Ddoiron-cidco/Poseidon-PCB/PSU/PCB-Rev.1/bot.jpg

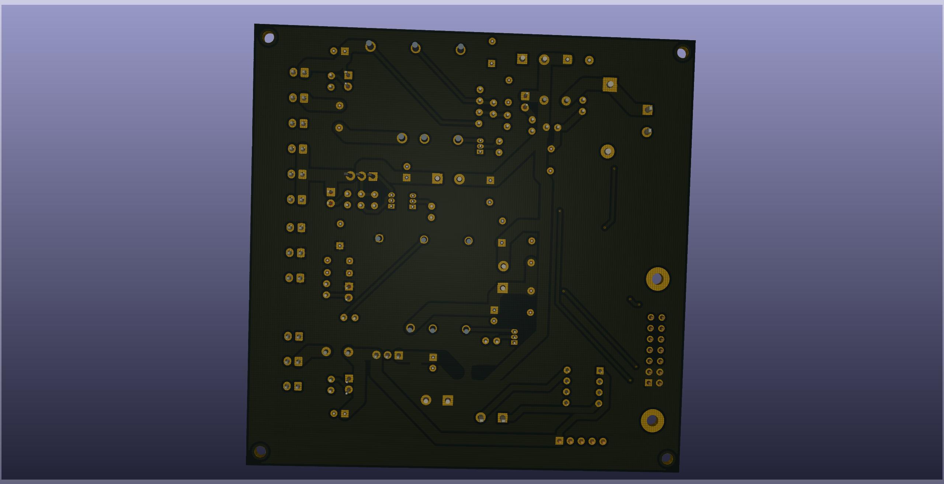
PSU/PCB-Rev.1/bot.jpg
