Ddoiron-cidco/Poseidon-PCB/PSU/PCB-Rev.1/pcb.jpg

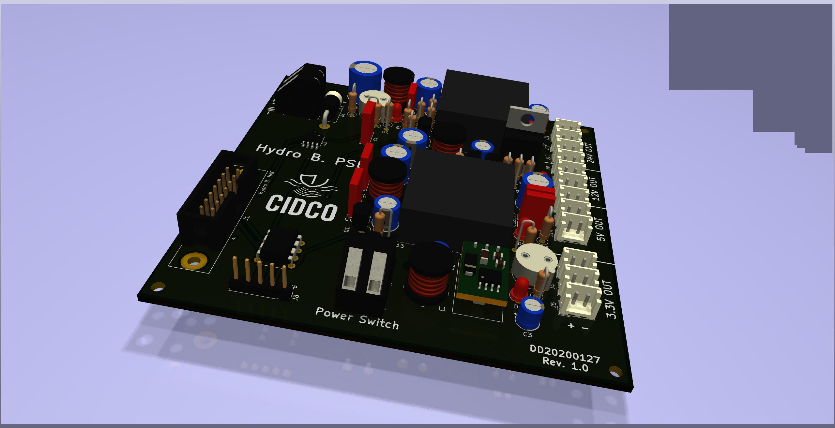
PSU/PCB-Rev.1/pcb.jpg
