Ddoiron-cidco/Poseidon-PCB/README.md

# Poseidon-PCB
PCBs for Poseidon Project

PCBs are design with Kicad 5.0
