Ddoiron-cidco/Poseidon-PCB/HAT/PCB Rev.1/pcb bot.jpg

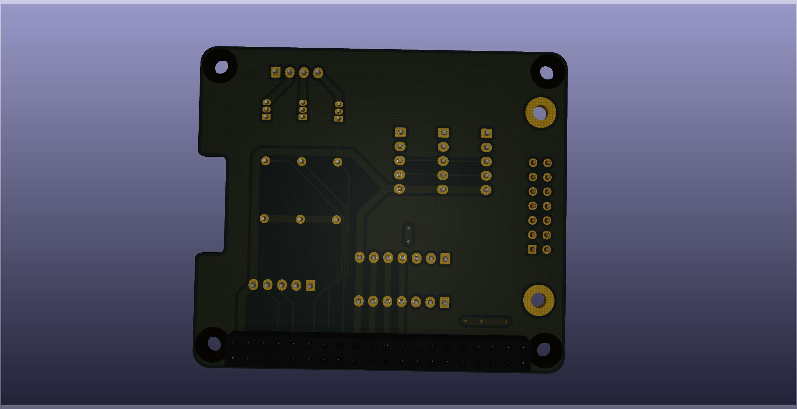
HAT/PCB Rev.1/pcb bot.jpg
