Ddoiron-cidco/Poseidon-PCB/HAT/PCB Rev.1/pcb top.jpg

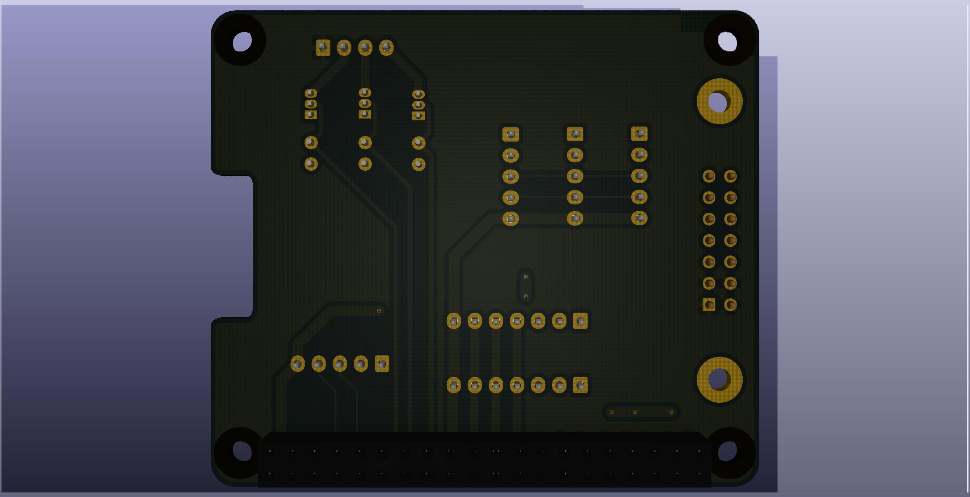
HAT/PCB Rev.1/pcb top.jpg
