Ddoiron-cidco/Poseidon-PCB/HAT/PCB Rev.1/pcb.jpg

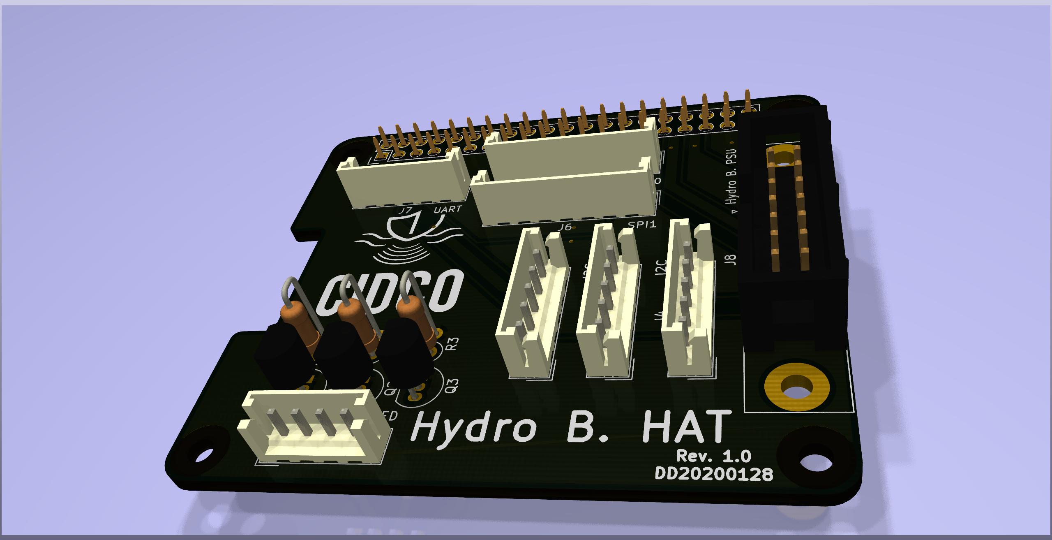
HAT/PCB Rev.1/pcb.jpg
