Ddoiron-cidco/Poseidon-PCB/PSU/PCB-Rev.1/top.jpg

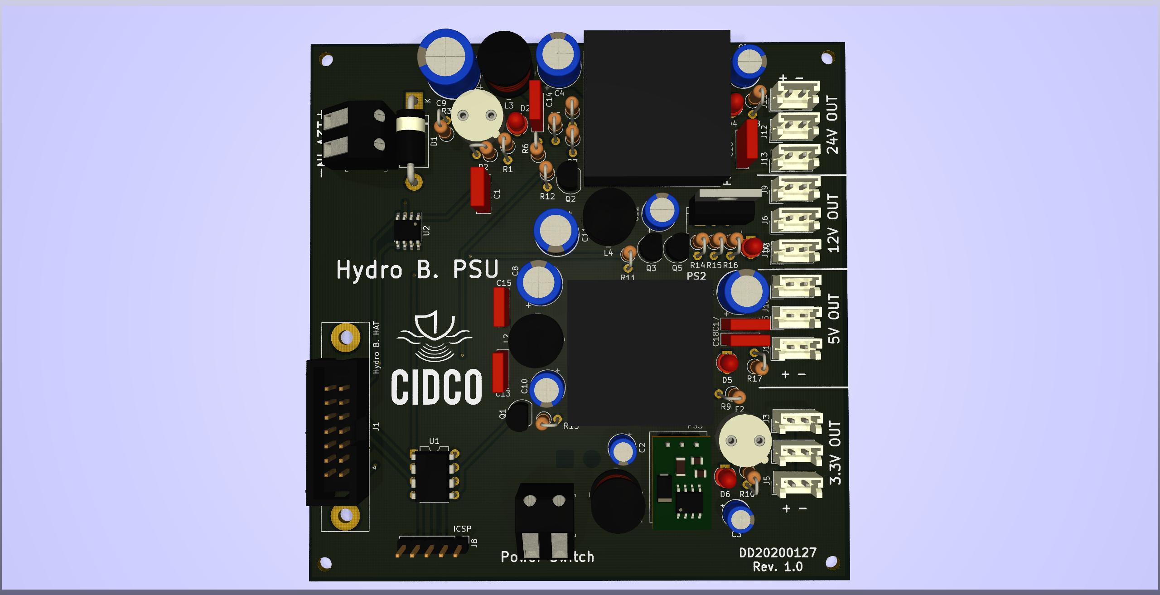
PSU/PCB-Rev.1/top.jpg
