Ddoiron-cidco/Poseidon-PCB/PSU/BOM PSU.ods

BOM
Hydro B. HAT
Location | Desc. | MFG PN | Digikey PN | Mouser PN | Newark PN | Arow PN
J1 | Wire-To-Board Connector, 2.54 mm, 14 Contacts, Header, FCI Quickie 71918 Series, Through Hole | 71918-214LF | 609-4495-ND | 649-71918-214LF | 62K7345 | 71918-214LF
J2,J7 | TERMINAL BLOCK, SCREW TYPE, 5.08 | TB007-508-02BE | 102-6203-ND | 490-TB007-508-02BE | *** | TB007-508-02BE
J3-J6,J9-J16 | CONN HEADER VERT 2POS 2.5MM | B2B-EH-A(LF)(SN) | 455-1611-ND | *** | 53X3090 | B2B-EH-A(LF)(SN)
J8 | NOT POPULATED
F1,F2 | FUSE HOLDER RADIAL 250V 6.3A PCB | 56000001009 | WK6235-ND | 576-56000001009 | 15P8392 | 56000001009
D1 | DIODE SCHOTTKY 40V 3A AXIAL | MBR340RLG | MBR340RLGOSCT-ND | 863-MBR340G | 38K4514 | MBR340RLG
D2-D6 | LED RED CLEAR T-1 T/H | WP710A10SECK/J3 | 754-1756-ND | 604-WP710A10SECKJ3 | *** | WP710A10SECK/J3
R1,R14,R15 | 10 kOhms ±1% 0.25W, 1/4W Through Hole Resistor Axial Metal Film | MFR-25FBF52-10K | 10.0KXBK-ND | 603-MFR-25FBF52-10K | *** | ***
R2 | 7.87 kOhms ±1% 0.25W, 1/4W Through Hole Resistor Axial Metal Film | MFR-25FBF52-7K87 | 7.87KXBK-ND | 603-MFR-25FBF52-7K87 | *** | ***
R3 | 1.27 kOhms ±1% 0.25W, 1/4W Through Hole Resistor Axial Metal Film | MFR-25FBF52-1K27 | 1.27KXBK-ND | 603-MFR-25FBF52-1K27 | *** | ***
R4
R5 | 20 kOhms ±1% 0.25W, 1/4W Through Hole Resistor Axial Metal Film | MFR-25FBF52-20K | 20.0KXBK-ND | 603-MFR-25FBF52-20K | *** | ***
R6 | 2.87 kOhms ±1% 0.25W, 1/4W Through Hole Resistor Axial Metal Film | MFR-25FBF52-2K87 | 2.87KXBK-ND | 603-MFR-25FBF52-2K87 | *** | ***
R7 | 24.9 kOhms ±1% 0.25W, 1/4W Through Hole Resistor Axial Metal Film | MFR-25FBF52-24K9 | 24.9KXBK-ND | 603-MFR-25FBF52-24K9 | *** | ***
R9
R10 | 220 Ohms ±5% 0.25W, 1/4W Through Hole Resistor Axial Carbon Film | CFR-25JB-52-220R | 220QBK-ND | 603-CFR-25JB-52-220R | *** | ***
R11-13 | 1 kOhms ±1% 0.25W, 1/4W Through Hole Resistor Axial Metal Film | MFR-25FBF52-1K | 1.00KXBK-ND | 603-MFR-25FBF52-1K | *** | ***
R16 | 2 kOhms ±1% 0.25W, 1/4W Through Hole Resistor Axial Metal Film | MFR-25FBF52-2K | 2.00KXBK-ND | 603-MFR-25FBF52-2K | *** | ***
R17 | 560 Ohms ±5% 0.25W, 1/4W Through Hole Resistor Axial Carbon Film | CFR-25JB-52-560R | 560QBK-ND | 603-CFR-25JB-52-560R | *** | ***
R18 | 3.9 kOhms ±5% 0.25W, 1/4W Through Hole Resistor Axial Carbon Film | CFR-25JB-52-3K9 | 3.9KQBK-ND | 603-CFR-25JB-52-3K9 | *** | ***
C1,C15,C18 | 0.1µF ±10% 50V Ceramic Capacitor X7R Radial | C322C104K5R5TA | 399-4329-ND | 80-C322C104K5R | 18K5744 | C322C104K5R5TA
C2,C3 | CAP ALUM 10UF 20% 35V RADIAL | ECA-1VM100I | P19549CT-ND | 667-ECA-1VM100I | *** | ECA-1VM100I
C4,C8,C11 | CAP ALUM 100UF 20% 50V RADIAL | ECA-1HHG101B | P19446CT-ND | 667-ECA-1HHG101B | *** | ***
C5,C10,C12 | CAP ALUM 47UF 20% 50V RADIAL | ECA-1HM470 | P5181-ND | 667-ECA-1HM470 | *** | ECA-1HM470
C7,C9 | CAP ALUM 330UF 20% 50V RADIAL | ECA-1HM331 | P5184-ND | 667-ECA-1HM331 | *** | ECA-1HM331
C13,C17 | CAP CER 10UF 50V X5R RADIAL | FG26X5R1H106KRT06 | 445-173434-1-ND | 810-FG26X5R1H106KRT6 | *** | FG26X5R1H106KRT06
C14 | CAP CER 4.7UF 50V X5R RADIAL | FG24X5R1H475KRT00 | 445-181258-ND | 810-FG24X5R1H475KRT0 | *** | FG24X5R1H475KRT00
C16 | CAP CER 1000PF 2KV Y5P RADIAL | S102K33Y5PP63K5R | 1252PH-ND | 594-S102K33Y5PP63K5R | S102K33Y5PP63K5R | S102K33Y5PP63K5R
L1,L2,L4 | FIXED IND 1UH 10A 13 MOHM TH | RL622-1R0K-RC | M9975-ND | 652-RL622-1R0K-RC | 86K3356 | RL622-1R0K-RC
L3 | FIXED IND 2.2UH 6.5A 21 MOHM TH | RL622-2R2K-RC | M9977-ND | 652-RL622-2R2K-RC | 86K3375 | RL622-2R2K-RC
Q1-Q3,Q5 | MOSFET Transistor, N Channel, 200 mA, 60 V, 1.2 ohm, 10 V, 2.1 V | 2N7000 | 2N7000FS-ND | 512-2N7000 | 98K6267 | 2N7000
Q4 | MOSFET P-CH 60V 27A TO-220 | FQP27P06 | FQP27P06-ND | 512-FQP27P06 | 58K1524 | FQP27P06
PS1 | DC-DC ISOLATED, 20 W, 9-36 VDC I | PDQE20-Q24-S24-D | 102-6270-ND | 490-PDQE20-Q24-S24-D | *** | ***
PS2 | DC DC CONVERTER 5V 30W | SKMW30F-05 | 1866-4667-ND |  | *** | SKMW30F-05
PS3 | DC DC CONVERTER 3.3V 5W | OKI-78SR-3.3/1.5-W36H-C | 811-3014-ND | 580-OKI78SR3.31.5WHC | 58T9850 | ***
U1 | IC MCU 8BIT 1.75KB FLASH 8DIP | PIC12F1501-I/P | PIC12F1501-I/P-ND | 579-PIC12F1501-I/P | 93T7733 | PIC12F1501-I/P
U2 | IC ADC 16BIT SIGMA-DELTA 8SOIC | MCP3426A0T-E/SN | MCP3426A0T-E/SNCT-ND | 579-MCP3426A0TE/SN | *** | ***
