Ddoiron-cidco/Poseidon-PCB/HAT/BOM HAT.ods

BOM
Hydro B. HAT
Location | Desc. | MFG PN | Digikey PN | Mouser PN | Newark PN | Arow PN
J1,J3,J4,J7 | Conn Shrouded Header (3 Sides) HDR 5 POS 2.5mm Solder ST Thru-Hole Box | B5B-EH-A(LF)(SN) | 455-1614-ND | *** | 90R8570 | B5B-EH-A(LF)(SN)
J2 | Headers & Wire Housings BOARDMT SKT HDR 40POS | 929852-01-20-RB | 3M156097-ND | 517-929852-01-20-RB | 62R6589 | 929852-01-20-RB
J5,J6 | Conn Shrouded Header (3 Sides) HDR 7 POS 2.5mm Solder ST Thru-Hole Box | B7B-EH-A(LF)(SN) | 455-1616-ND | *** | 90R8575 | B7B-EH-A(LF)(SN)
J8 | Wire-To-Board Connector, 2.54 mm, 14 Contacts, Header, FCI Quickie 71918 Series, Through Hole | 71918-214LF | 609-4495-ND | 649-71918-214LF | 62K7345 | 71918-214LF
J9 | Conn Shrouded Header (3 Sides) HDR 4 POS 2.5mm Solder ST Thru-Hole Box | B4B-EH-A(LF)(SN) | 455-1613-ND | *** | 90R8567 | B4B-EH-A(LF)(SN)
R1,R2,R3 | Through Hole Resistor, 1 kohm, MCF Series, 250 mW, ± 5%, Axial Leaded, 250 V | CFR-25JB-1K0 | 1.0KQBK-ND | 603-CFR-25JB-1K0 | 38K0327 | ***
Q1,Q2,Q3 | MOSFET Transistor, N Channel, 200 mA, 60 V, 1.2 ohm, 10 V, 2.1 V | 2N7000 | 2N7000FS-ND | 512-2N7000 | 98K6267 | 2N7000
