Ddoiron-cidco/Poseidon-PCB/HAT/PCB Rev.1/gerbers/fab.pdf

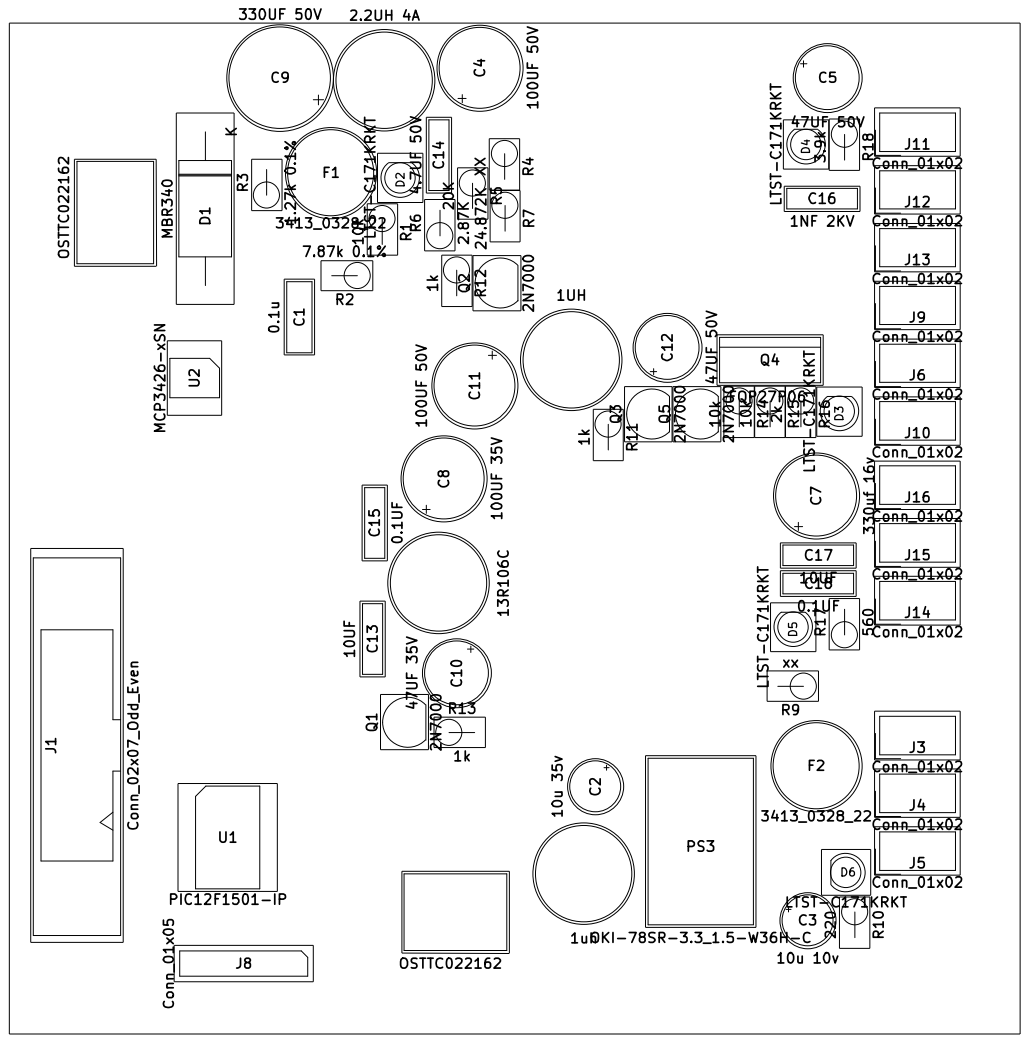
[picture p8: page 1]
