Ddoiron-cidco/Poseidon-PCB/PSU/PCB-Rev.1/psu-pcb.kicad_pcb

## KiCad design PSU/PCB-Rev.1/psu-pcb.kicad_pcb (2020-06-30)

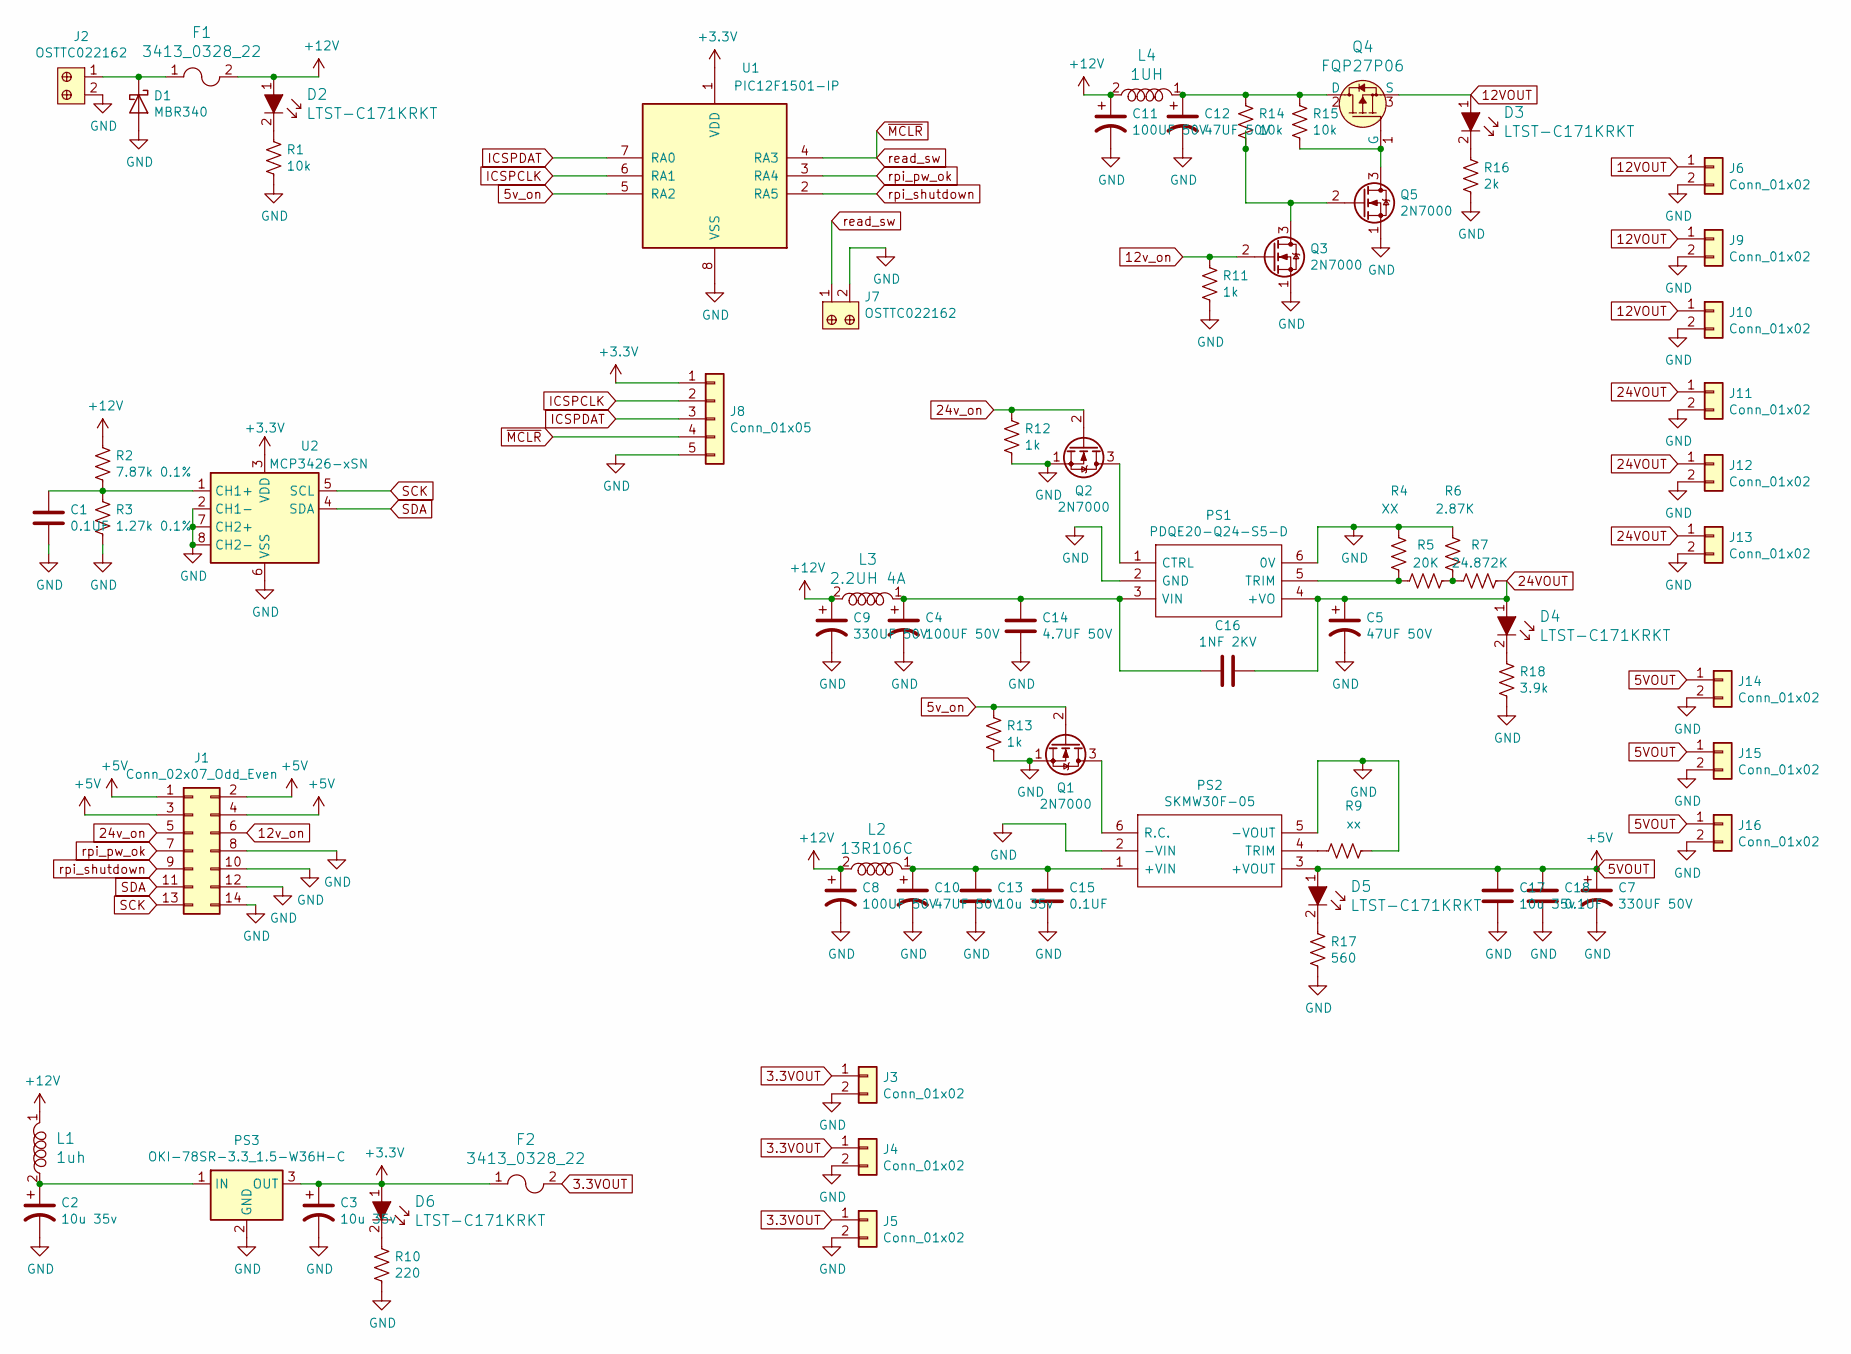
[picture p9: schematic psu-pcb.sch, Poseidon PSU]

Parts:
C1, C15, C18: 0.1UF; C_Rect_L7.0mm_W2.5mm_P5.00mm
C2, C3: 10u 35v; CP_Radial_D5.0mm_P2.50mm
C4, C8, C11: 100UF 50V; CP_Radial_D8.0mm_P5.00mm
C5, C10, C12: 47UF 50V; CP_Radial_D6.3mm_P2.50mm
C7, C9: 330UF 50V; CP_Radial_D10.0mm_P5.00mm
C13, C17: 10u 35v; C_Rect_L7.0mm_W2.0mm_P5.00mm
C14: 4.7UF 50V; C_Rect_L7.0mm_W2.0mm_P5.00mm
C16: 1NF 2KV; C_Rect_L7.0mm_W2.0mm_P5.00mm
D1: MBR340; D_DO-201AD_P15.24mm_Horizontal
D2, D3, D4, D5, D6: LTST-C171KRKT; LED_D3.0mm_Clear; MPN LTST-C171KRKT; Digi-Key_PN 160-1427-1-ND
F1, F2: 3413_0328_22; Fuse_Littelfuse_372_D8.50mm; MPN 3413.0328.22; Digi-Key_PN 486-1686-1-ND
J1: Conn_02x07_Odd_Even; IDC-Header_2x07_P2.54mm_Vertical_Lock
J2, J7: OSTTC022162; Term_Block_1x2_P5.08MM; MPN OSTTC022162; Digi-Key_PN ED2609-ND
J3, J4, J5, J6, J9, J10, J11, J12, J13, J14, J15, J16: Conn_01x02; JST_EH_B2B-EH-A_1x02_P2.50mm_Vertical
J8: Conn_01x05; PinHeader_1x05_P2.54mm_Vertical
L1: 1uh; Inductor_13R106C; MPN 13R106C; Digi-Key_PN 811-2058-ND
L2: 13R106C; Inductor_13R106C; MPN 13R106C; Digi-Key_PN 811-2058-ND
L3: 2.2UH 4A; Inductor_13R106C; MPN 13R106C; Digi-Key_PN 811-2058-ND
L4: 1UH; Inductor_13R106C; MPN 13R106C; Digi-Key_PN 811-2058-ND
PS1: PDQE20-Q24-S5-D; PDQE15Q24S5D; Manufacturer_Part_Number PDQE20-Q24-S5-D; Mouser Part Number 490-PDQE20-Q24-S5-D
PS2: SKMW30F-05; SKMW30G12; Manufacturer_Part_Number SKMW30G-12; Mouser Part Number 709-SKMW30G-12
PS3: OKI-78SR-3.3_1.5-W36H-C; Converter_DCDC_muRata_OKI-78SR_Horizontal
Q1, Q2, Q3, Q5: 2N7000; TO-92_Inline
Q4: FQP27P06; TO-220-3; MPN FQP27P06; Digi-Key_PN FQP27P06-ND
R1, R14, R15: 10k; R_Axial_DIN0207_L6.3mm_D2.5mm_P2.54mm_Vertical
R2: 7.87k 0.1%; R_Axial_DIN0207_L6.3mm_D2.5mm_P2.54mm_Vertical
R3: 1.27k 0.1%; R_Axial_DIN0207_L6.3mm_D2.5mm_P2.54mm_Vertical
R4: XX; R_Axial_DIN0207_L6.3mm_D2.5mm_P2.54mm_Vertical
R5: 20K; R_Axial_DIN0207_L6.3mm_D2.5mm_P2.54mm_Vertical
R6: 2.87K; R_Axial_DIN0207_L6.3mm_D2.5mm_P2.54mm_Vertical
R7: 24.872K; R_Axial_DIN0207_L6.3mm_D2.5mm_P2.54mm_Vertical
R9: xx; R_Axial_DIN0207_L6.3mm_D2.5mm_P2.54mm_Vertical
R10: 220; R_Axial_DIN0207_L6.3mm_D2.5mm_P2.54mm_Vertical
R11, R12, R13: 1k; R_Axial_DIN0207_L6.3mm_D2.5mm_P2.54mm_Vertical
R16: 2k; R_Axial_DIN0207_L6.3mm_D2.5mm_P2.54mm_Vertical
R17: 560; R_Axial_DIN0207_L6.3mm_D2.5mm_P2.54mm_Vertical
R18: 3.9k; R_Axial_DIN0207_L6.3mm_D2.5mm_P2.54mm_Vertical
U1: PIC12F1501-IP; DIP-8_W7.62mm
U2: MCP3426-xSN; SOIC-8-1EP_3.9x4.9mm_P1.27mm_EP2.29x3mm

Connections:
3.3VOUT: F2.2, J3.1, J4.1, J5.1
5VOUT: C7.1, C17.1, C18.1, D5.1, J1.1, J1.2, J1.3, J1.4, J14.1, J15.1, J16.1, PS2.3 (+VOUT)
5v_on: Q1.2 (G), R13.1, U1.5 (RA2)
12VOUT: D3.1, J6.1, J9.1, J10.1, Q4.3 (S)
12v_on: J1.6, Q3.2 (G), R11.1
24VOUT: C5.1, C16.2, D4.1, J11.1, J12.1, J13.1, PS1.4 (+VO), R7.2
24v_on: J1.5, Q2.2 (G), R12.1
+3V3: C3.1, D6.1, F2.1, J8.1, PS3.3 (OUT), U1.1 (VDD), U2.3 (VDD)
+12V: C8.1, C9.1, C11.1, D2.1, F1.2, L1.1, L2.2, L3.2, L4.2, R2.1
GND: C1.2, C2.2, C3.2, C4.2, C5.2, C7.2, C8.2, C9.2, C10.2, C11.2, C12.2, C13.2, C14.2, C15.2, C17.2, C18.2, D1.2 (A), J1.8, J1.10, J1.12, J1.14, J2.2, J3.2, J4.2, J5.2, J6.2, J7.2, J8.5, J9.2, J10.2, J11.2, J12.2, J13.2, J14.2, J15.2, J16.2, PS1.2 (GND), PS1.6 (0V), PS2.2 (-VIN), PS2.5 (-VOUT), PS3.2 (GND), Q1.1 (S), Q2.1 (S), Q3.1 (S), Q5.1 (S), R1.2, R3.2, R4.1, R6.1, R9.2, R10.2, R11.2, R12.2, R13.2, R16.2, R17.2, R18.2, U1.8 (VSS), U2.2 (CH1-), U2.6 (VSS), U2.7 (CH2+), U2.8 (CH2-)
ICSPCLK: J8.2, U1.6 (RA1)
ICSPDAT: J8.3, U1.7 (RA0)
unnamed: C2.1, L1.2, PS3.1 (IN)
unnamed: C10.1, C13.1, C15.1, L2.1, PS2.1 (+VIN)
unnamed: C12.1, L4.1, Q4.2 (D), R14.1, R15.1
unnamed: C4.1, C14.1, C16.1, L3.1, PS1.3 (VIN)
unnamed: D1.1 (K), F1.1, J2.1
unnamed: D2.2, R1.1
unnamed: D3.2, R16.1
unnamed: D4.2, R18.1
unnamed: D5.2, R17.1
unnamed: D6.2, R10.1
unnamed: PS1.1 (CTRL), Q2.3 (D)
unnamed: PS1.5 (TRIM), R4.2, R5.1
unnamed: PS2.4 (TRIM), R9.1
unnamed: PS2.6 (R.C.), Q1.3 (D)
unnamed: Q3.3 (D), Q5.2 (G), R14.2
unnamed: Q4.1 (G), Q5.3 (D), R15.2
unnamed: R5.2, R6.2, R7.1
SCK: J1.13, U2.5 (SCL)
SDA: J1.11, U2.4 (SDA)
read_sw: J7.1, J8.4, U1.4 (RA3)
rpi_pw_ok: J1.7, U1.3 (RA4)
rpi_shutdown: J1.9, U1.2 (RA5)

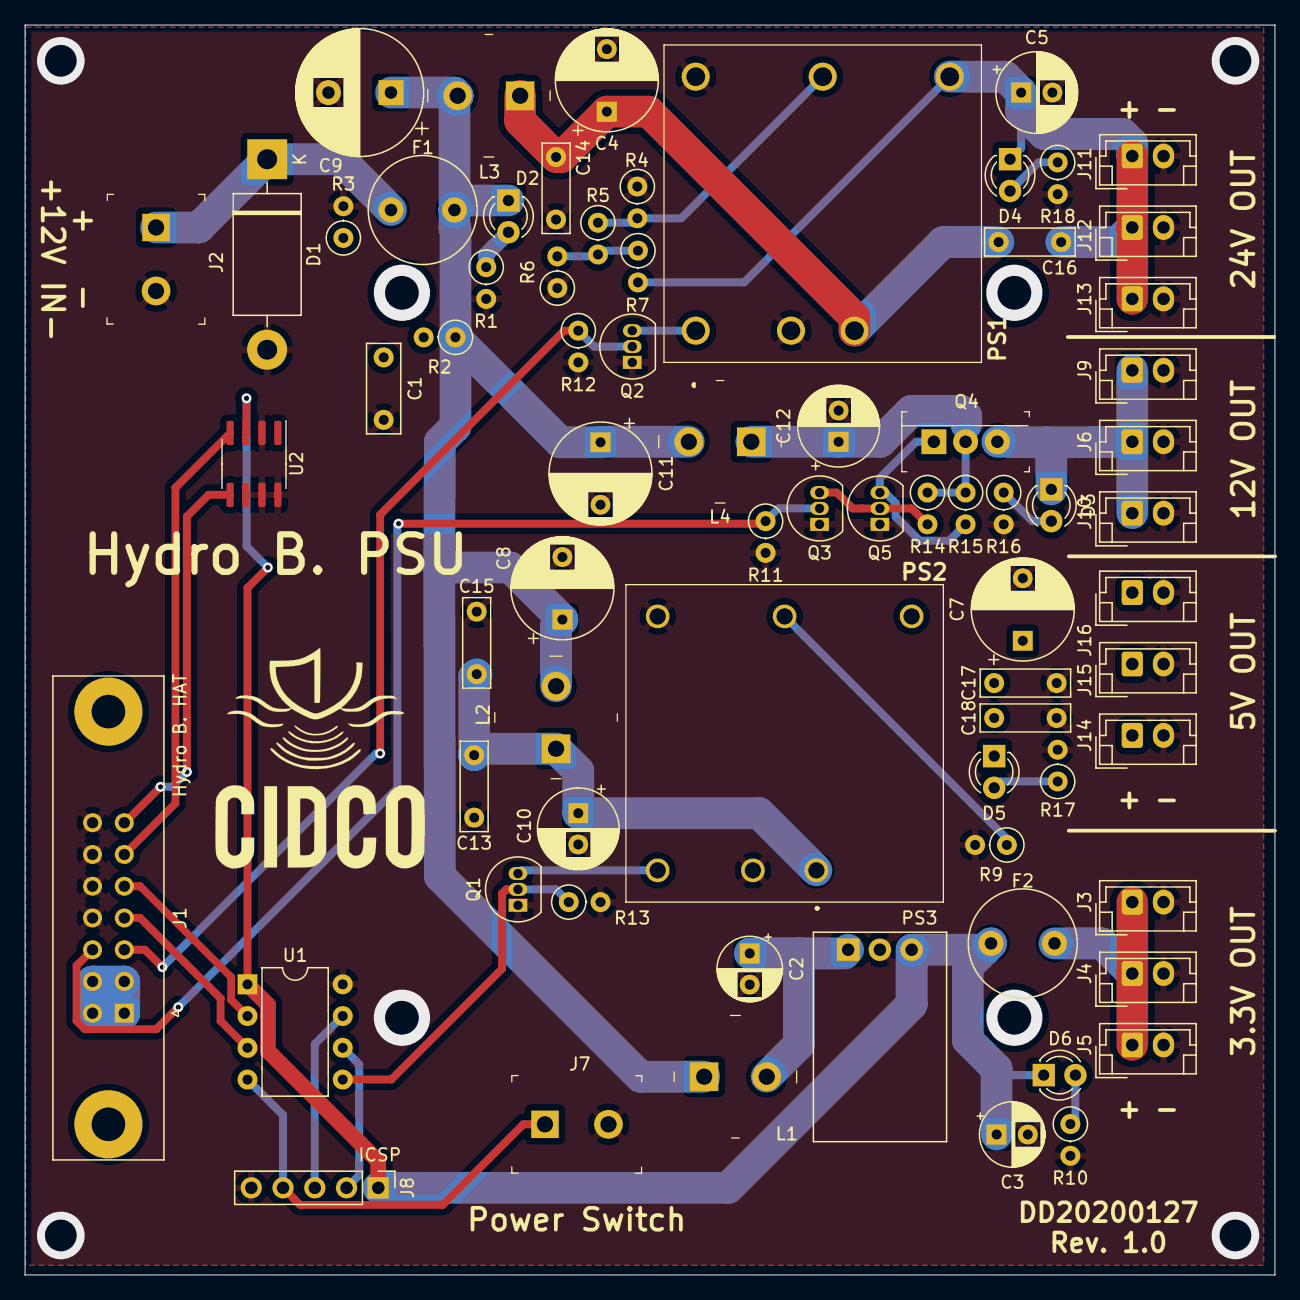
[picture p10: board psu-pcb.kicad_pcb from above]

Board: 2 copper layers, 100.0 x 100.0 mm, 72 parts (0 on the bottom side), 34 nets.
