Ddoiron-cidco/Poseidon-PCB/HAT/PCB Rev.1/RPi_Hat.kicad_pcb

## KiCad design HAT/PCB Rev.1/RPi_Hat.kicad_pcb (2020-01-30)

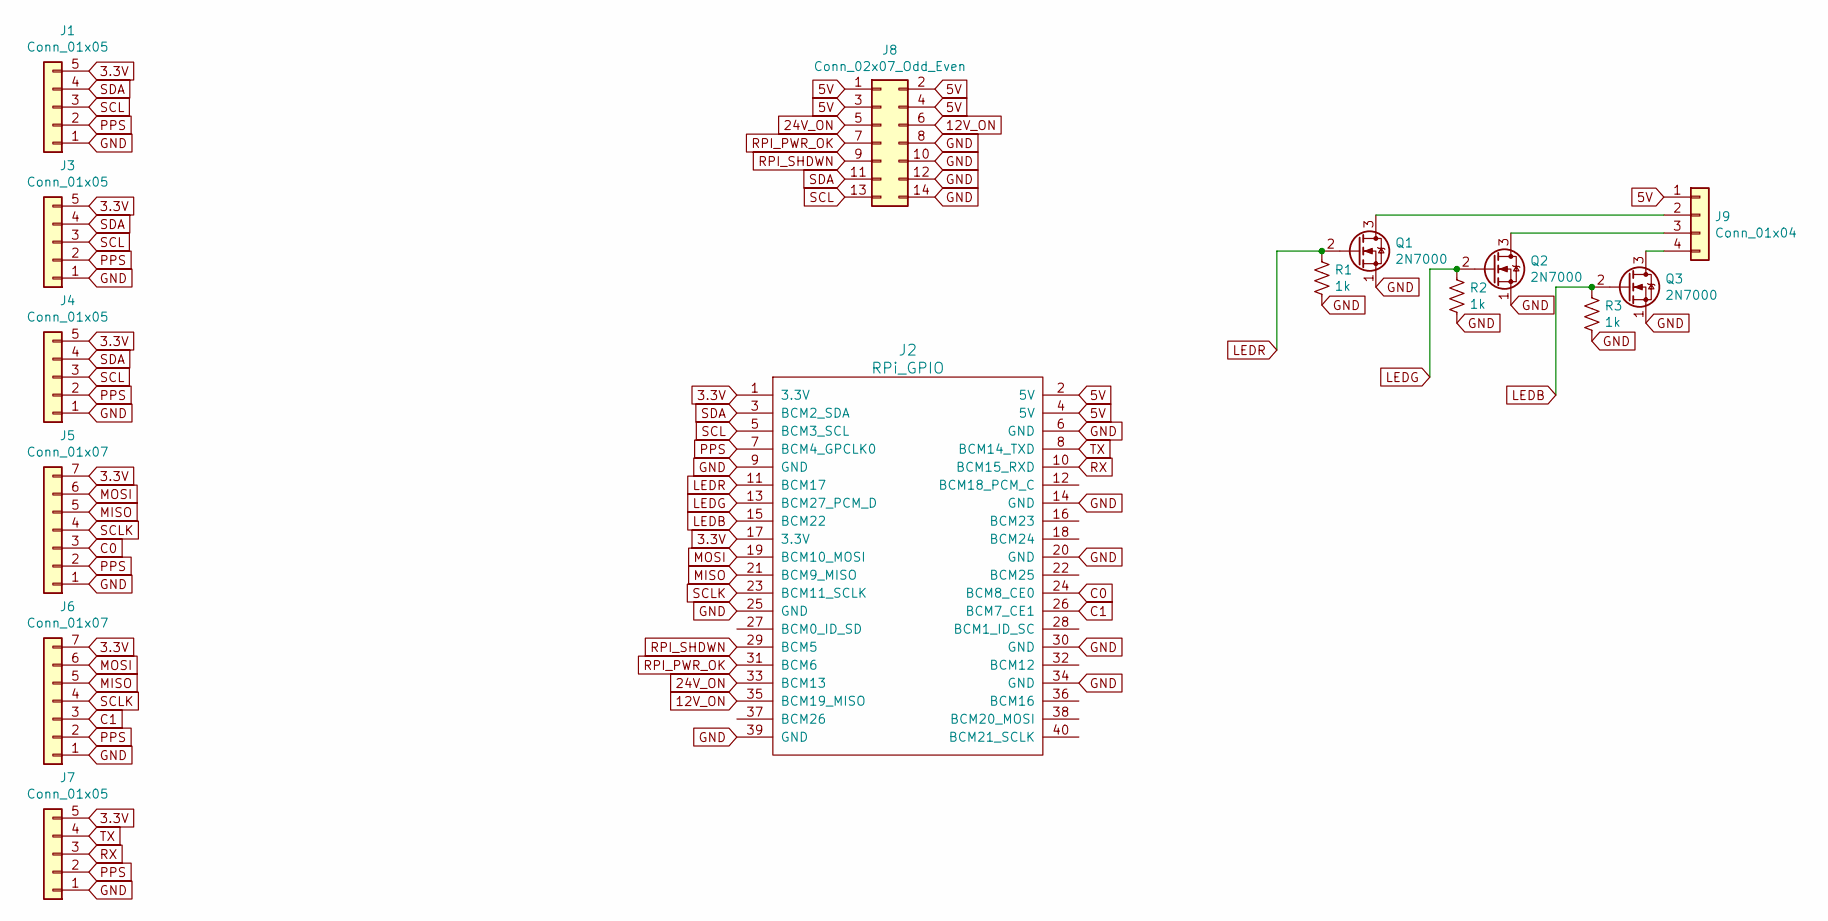
[picture p11: schematic RPi_GPIO.sch]

Parts:
J1, J3, J4, J7: Conn_01x05; JST_EH_B5B-EH-A_1x05_P2.50mm_Vertical
J2: RPi_GPIO; Pin_Header_Straight_2x20
J5, J6: Conn_01x07; JST_EH_B7B-EH-A_1x07_P2.50mm_Vertical
J8: Conn_02x07_Odd_Even; IDC-Header_2x07_P2.54mm_Vertical_Lock
J9: Conn_01x04; JST_EH_B4B-EH-A_1x04_P2.50mm_Vertical
Q1, Q2, Q3: 2N7000; TO-92_Inline
R1, R2, R3: 1k; R_Axial_DIN0207_L6.3mm_D2.5mm_P10.16mm_Horizontal

Connections:
3.3V: J1.5, J2.1 (3.3V), J2.17 (3.3V), J3.5, J4.5, J5.7, J6.7, J7.5
5V: J2.2 (5V), J2.4 (5V), J8.1, J8.2, J8.3, J8.4, J9.1
12V_ON: J2.35 (BCM19_MISO), J8.6
24V_ON: J2.33 (BCM13), J8.5
C0: J2.24 (BCM8_CE0), J5.3
C1: J2.26 (BCM7_CE1), J6.3
GND: J1.1, J2.6 (GND), J2.9 (GND), J2.14 (GND), J2.20 (GND), J2.25 (GND), J2.30 (GND), J2.34 (GND), J2.39 (GND), J3.1, J4.1, J5.1, J6.1, J7.1, J8.8, J8.10, J8.12, J8.14, Q1.1 (S), Q2.1 (S), Q3.1 (S), R1.2, R2.2, R3.2
LEDB: J2.15 (BCM22), Q3.2 (G), R3.1
LEDG: J2.13 (BCM27_PCM_D), Q2.2 (G), R2.1
LEDR: J2.11 (BCM17), Q1.2 (G), R1.1
MISO: J2.21 (BCM9_MISO), J5.5, J6.5
MOSI: J2.19 (BCM10_MOSI), J5.6, J6.6
unnamed: J9.2, Q1.3 (D)
unnamed: J9.3, Q2.3 (D)
unnamed: J9.4, Q3.3 (D)
PPS: J1.2, J2.7 (BCM4_GPCLK0), J3.2, J4.2, J5.2, J6.2, J7.2
RPI_PWR_OK: J2.31 (BCM6), J8.7
RPI_SHDWN: J2.29 (BCM5), J8.9
RX: J2.10 (BCM15_RXD), J7.3
SCL: J1.3, J2.5 (BCM3_SCL), J3.3, J4.3, J8.13
SCLK: J2.23 (BCM11_SCLK), J5.4, J6.4
SDA: J1.4, J2.3 (BCM2_SDA), J3.4, J4.4, J8.11
TX: J2.8 (BCM14_TXD), J7.4

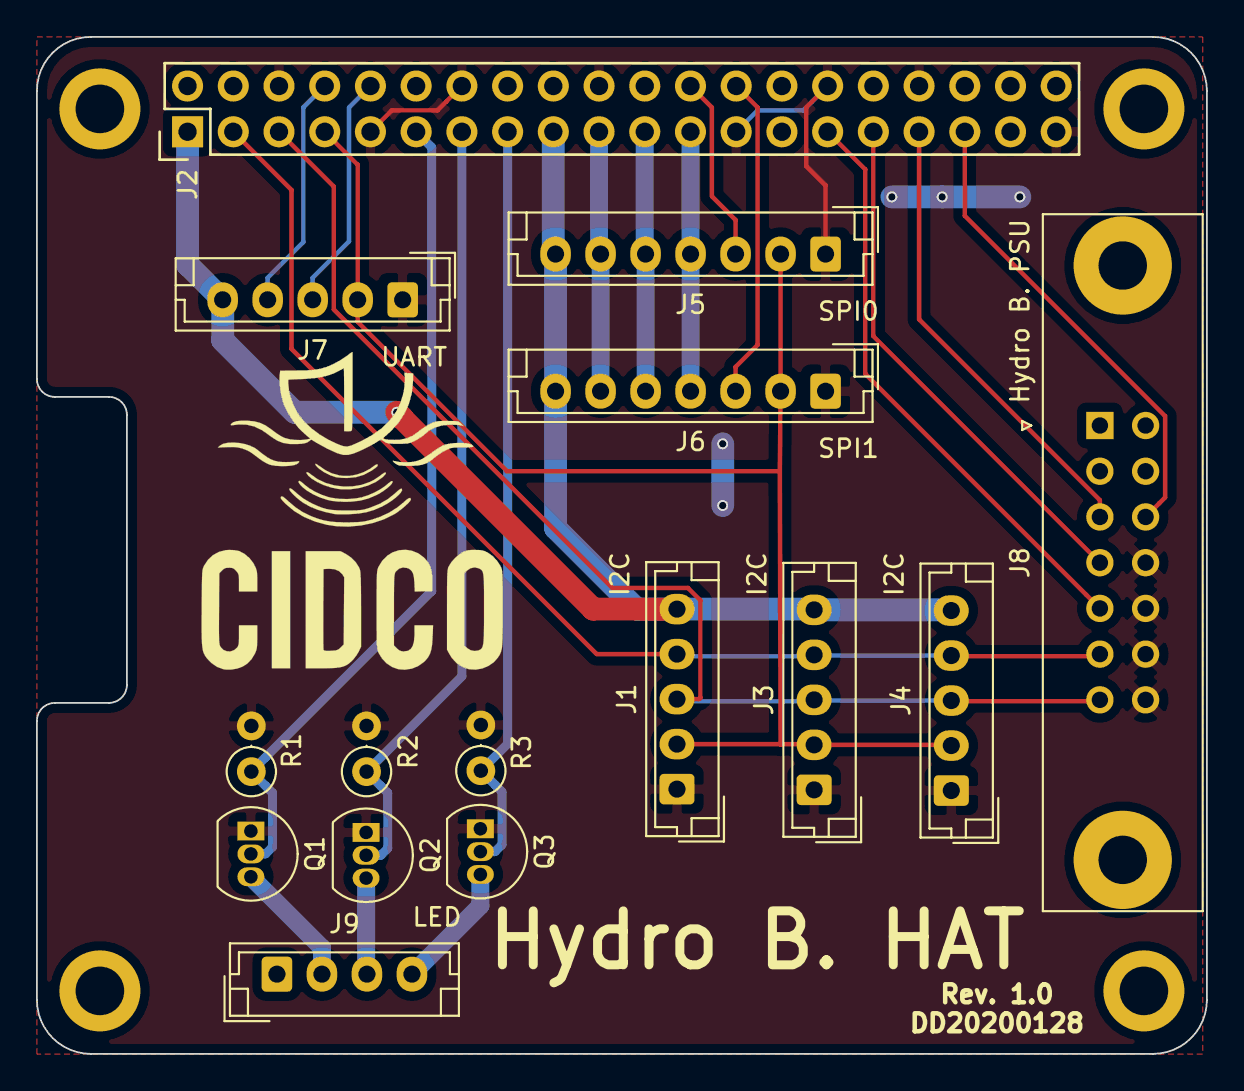
[picture p12: board RPi_Hat.kicad_pcb from above]

Board: 2 copper layers, 65.0 x 56.5 mm, 15 parts (0 on the bottom side), 23 nets.
