Ddoiron-cidco/Poseidon-PCB/(commit log)

2020-01-27 update sch file for psu
    [Part list.ods]
2020-01-27 Poseidon PSU pcb
    [psu-pcb.sch]
2020-01-28 schematic update
2020-01-28 psu ready to be validated
    [psu-pcb.kicad_pcb]
2020-01-28 update module daughter
    [RPi_GPIO.sch, RPi_Hat.kicad_pcb, RPi_Hat.sch]
2020-01-28 Removed submodule Daughter-board/RPi_Hat_Template
2020-01-29 photo pcb Daughter
2020-01-29 update psu and hat
    [RPi_Hat.kicad_pcb, psu-pcb.kicad_pcb, psu-pcb.sch]
2020-01-29 pcb images
2020-01-29 smt to TH
    [RPi_GPIO.sch, RPi_Hat.kicad_pcb, psu-pcb.kicad_pcb, psu-pcb.sch]
2020-01-30 update hat
    [RPi_Hat.kicad_pcb]
2020-01-30 gerber files
    [BOM HAT.ods, BOM HAT.xls, BOM PSU light.xls, BOM PSU.csv, BOM PSU.ods, BOM PSU.xls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]
2020-01-30 update BOM pour digikey
    [BOM HAT.xls, BOM PSU.xls]
2020-06-30 ajout bornier pour supporter le rpi sur le psu
    [psu-pcb-B_Cu.gbl, psu-pcb-B_Mask.gbs, psu-pcb-B_Paste.gbp, psu-pcb-B_SilkS.gbo, psu-pcb-Edge_Cuts.gm1, psu-pcb-F_Cu.gtl, psu-pcb-F_Mask.gts, psu-pcb-F_Paste.gtp]
