Ddoiron-cidco/Poseidon-PCB/(notices)

Notices in the files:
PSU/PCB-Rev.1/psu-pcb.sch:
creativecommons.org/licenses/by/4.0
License: CC BY 4.0
